OSSGolf/osstempo/pcb/renders/v1.0-top.png

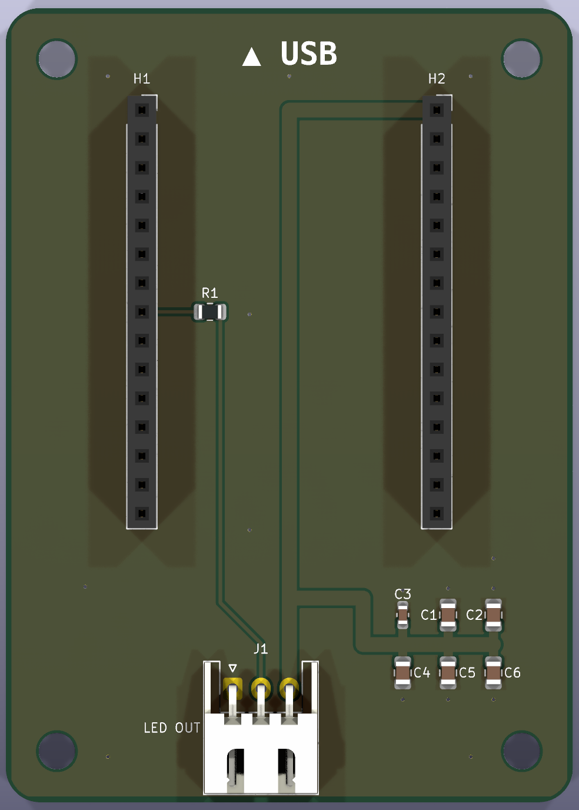
pcb/renders/v1.0-top.png
