OSSGolf/osstempo/pcb/build/jlcpcb_order/osstempo_led_carrier-v1.2-bom.csv

Comment | Designator | Footprint | LCSC Part #
22uF | C1,C2,C3,C4,C5,C6 | C_0805_2012Metric | C45783
470R | R1 | R_0805_2012Metric | C17710
