OSSGolf/osstempo/pcb/routed/osstempo_led_carrier/osstempo_led_carrier.kicad_pcb

## KiCad design pcb/routed/osstempo_led_carrier/osstempo_led_carrier.kicad_pcb (2026-11-03)

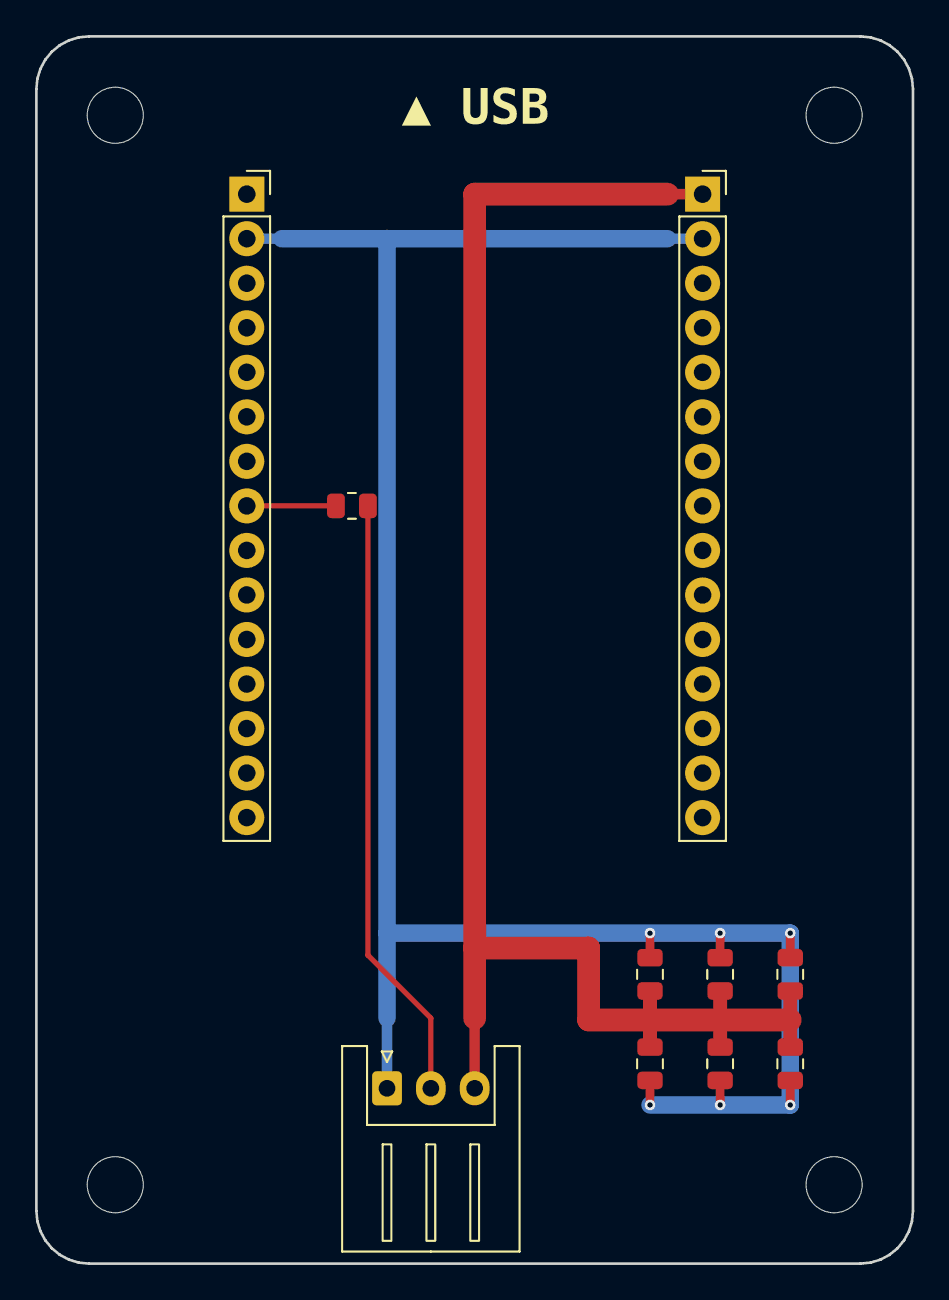
[picture p6: board osstempo_led_carrier.kicad_pcb from above]

Board: 2 copper layers, 50.0 x 70.0 mm, 16 parts (1 on the bottom side), 4 nets.

Parts:
C1, C2, C3, C4, C5, C6: 22uF; C_0805_2012Metric
H1, H2: ESP32_SOCKET; PinSocket_1x15_P2.54mm_Vertical_Pad2.0
J1: LED_OUT; JST_XH_S3B-XH-A_1x03_P2.50mm_Horizontal
MARK1: ▲ USB; Mark_USB_End
MH1, MH2, MH3, MH4: MountingHole_3.2mm
R1: 470R; R_0805_2012Metric
SILK1: arrow / arrow / GND / arrow / D5 / arrow / arrow 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; Silk_Back_v1_2

Connections:
5V: C1.1, C2.1, C3.1, C4.1, C5.1, C6.1, H2.1, J1.3
DIN: J1.2, R1.2
ESP32_IO5: H1.8, R1.1
GND: C1.2, C2.2, C3.2, C4.2, C5.2, C6.2, H1.2, H2.2, J1.1
