OSSGolf/osstempo/tempo_trainer/sync_firmware.ino

/*
 * sync_firmware.ino — ESP-NOW multi-stick sync (FW Phase 2–5, TEMPO_SYNC_PLAN.md).
 * =================================================================================
 * Additive sketch tab. Ephemeral, app-brokered roles held in RAM, default `standalone`
 * at boot (§2.1): WiFi/ESP-NOW is OFF until the app sends becomeLeader/joinSession over
 * BLE, so the lone-stick path pays ZERO coex/RAM cost. A leader broadcasts a SyncBeacon;
 * a follower renders phase-locked off the shared, epoch-anchored clock (§3.4/§4).
 *
 * Compile-verified on both boards; runtime skew/coex is bench-gated (Phase 0 GO required).
 * The shared-grid render integration + core-affinity task are staged (see syncFollowerU()).
 */

#include <WiFi.h>
#include <esp_wifi.h>
#include <esp_now.h>
#include <cstddef>            // offsetof (authTag MAC)
#include <mbedtls/md.h>       // HMAC-SHA256 for the beacon authTag (§4.2.1)
#include "sync_firmware.h"    // SyncRole enum + externs for the state the main tab reads

// ---- Ephemeral role (RAM only; default standalone at every boot). Non-static: matches the
//      extern declarations in sync_firmware.h so the main tab can read them. ----
volatile SyncRole syncRole = ROLE_STANDALONE;
static volatile bool wifiUp = false;            // up on core 0 (becomeLeader/join), down on core 1 (revert)
void syncDoDisband();                            // core-1 disband worker (defined below; called before its def)
void leaderServicePongs();                       // core-1 pong TX (defined below)
static uint8_t  chOp = 6;                       // operating channel handed by the app (§5.1)
static uint8_t  sessionKey[16] = {0};           // per-session key (RAM; authenticates the beacon, §4.2.1)
static uint16_t sessionId = 0;

static uint8_t BROADCAST_ADDR[6] = { 0xFF,0xFF,0xFF,0xFF,0xFF,0xFF };
static uint8_t myMac[6] = {0};                  // this stick's STA MAC (follower identity for identify)

// (SyncBeacon + BEACON_FLAG_DISBAND are declared in sync_firmware.h so the main tab sees them.)

// ---- Leader beacon state ----
static uint32_t beaconSeq = 0;
int64_t         leaderEpochUs = 0;              // shared cycle epoch (leader clock) — extern (header)
static uint32_t lastBeaconMs = 0;
static const uint32_t BEACON_KEEPALIVE_MS = 250;   // 4 Hz (§4.4)
static int64_t  leaderZeroSinceUs = 0;             // when the leader last had 0 followers (self-revert backstop)

// ---- Follower clock-offset estimate (min-filter over the last N samples, §4.3) ----
static const int OFFSET_WINDOW = 16;
static int64_t offsetSamples[OFFSET_WINDOW];
static int     offsetCount = 0, offsetIdx = 0;
static int64_t clockOffsetUs = 0;               // best clock offset (round-trip θ when available)
static int64_t owdUs = 0;                       // one-way delay from the round-trip pong (§4.3)
static bool    haveRtt = false;                 // do we have a round-trip offset yet?
static int64_t lastBeaconRxUs = 0;
static uint32_t followerLastSeq = 0;            // replay guard (monotonic seq, §4.2.1)
static bool    followerEverHeard = false;       // T_JOIN fast-revert if we never heard a beacon
static int64_t followerJoinUs = 0;              // when we became a follower (for the T_JOIN timeout)
static volatile uint32_t lastPingId = 0;        // our outstanding ping's id: 32-bit ⇒ atomic cross-core match (no torn 64-bit read)
static uint32_t pingIdNext = 0;                 // core-1 monotonic ping id, seeded per-follower from the MAC
static uint32_t lastPingMs = 0;

// Follower clock slew (§4.3/§13): ramp small offset corrections across frames, snap on first lock / big
// jump, so a fresh estimate every ~2 s can't hop the comet mid-stroke. Constants are bench-tunable.
static bool    followerOffsetInit = false;
static int64_t appliedOffsetUs = 0;
static const int64_t OFFSET_SLEW_STEP_US = 200;      // max correction per render tick (~250 Hz)
static const int64_t OFFSET_SNAP_US      = 3000;     // beyond this, snap (first lock / leader reboot)

// Deferred actions: SET in the RX callback (core 0), PERFORMED in loop() (core 1, the radio owner).
static volatile bool pendingRevert = false;     // #1: WiFi teardown must NOT run in the RX callback
static volatile bool identifyPending = false;   // #5: identifyBlink() (720ms) must NOT run in the callback
static volatile bool disbandPending = false;    // #4/#6: disband beacon-storm + teardown belong on core 1
static volatile bool statusDirty = false;       // #1: the …0012 BLE notify must NOT run in the RX callback

// Round-trip pong requests handed from the RX callback (core 0) to loop (core 1) so the pong is TXed
// OFF the WiFi RX callback (#2). SPSC ring under a portMUX; leaderTx is stamped at actual send time.
struct PongReq { uint32_t pingId; int64_t followerTx; int64_t leaderRx; };
static const int PONG_Q_CAP = 4;
static PongReq pongQueue[PONG_Q_CAP];
static int pongCount = 0;                        // guarded by pongMux (the spinlock is the barrier), like followerN
static portMUX_TYPE pongMux = portMUX_INITIALIZER_UNLOCKED;

// Follower render state, published via a SEQLOCK: single writer (core-0 RX cb), single reader
// (core-1 loop). Prevents torn reads of the 64-bit clock + the ~24-byte kinematic set (plan §3.5).
// (FollowerPub is declared in sync_firmware.h so the auto-prototypes resolve.)
static volatile uint32_t pubSeq = 0;
static FollowerPub pub = {};
static inline void publishFollower(const FollowerPub &v) {
  uint32_t s = pubSeq; pubSeq = s + 1;                   // odd → writing (explicit store: no volatile-++ warning)
  __sync_synchronize(); pub = v; __sync_synchronize();
  pubSeq = s + 2;                                        // even → published
}
static inline bool readFollower(FollowerPub &out) {
  for (int t = 0; t < 5; t++) {
    uint32_t s0 = pubSeq; __sync_synchronize();
    if (s0 & 1) continue;
    out = pub; __sync_synchronize();
    if (pubSeq == s0) return true;
  }
  return false;
}

// ---- Follower health as the leader tracks it (for the …0012 report), §6/§12 ----
struct FollowerRec { uint8_t mac[6]; int64_t lastHelloUs; bool settled; };
static const int MAX_FOLLOWERS = 4;
static FollowerRec followers[MAX_FOLLOWERS];
static int followerN = 0;
static portMUX_TYPE followersMux = portMUX_INITIALIZER_UNLOCKED;   // #7: core-0 add vs core-1 prune

// =====================================================================================
//  Radio bring-up / tear-down (paid ONLY while a set is active).
// =====================================================================================
static void syncWifiUp() {
  if (wifiUp) return;
  WiFi.mode(WIFI_STA);
  WiFi.disconnect(false, true);
  esp_wifi_set_ps(WIFI_PS_NONE);
  esp_wifi_set_channel(chOp, WIFI_SECOND_CHAN_NONE);
  esp_wifi_get_mac(WIFI_IF_STA, myMac);                 // our identity for addressed identify (§13-ask-2)
  if (esp_now_init() == ESP_OK) {
    esp_now_peer_info_t peer = {};
    memcpy(peer.peer_addr, BROADCAST_ADDR, 6);
    peer.channel = chOp; peer.encrypt = false;
    esp_now_add_peer(&peer);
    wifiUp = true;
  }
}

// Leader → a specific follower: broadcast an addressed identify; only the matching MAC blinks (§13-ask-2).
// Queue this stick's own identify blink for loop() on core 1. Called from the BLE task, which must
// never run the 720 ms blocking blink itself -- it writes leds[] and latches the strip concurrently
// with the renderer.
void syncDeferIdentifySelf() { identifyPending = true; }

void syncIdentifyFollower(const uint8_t mac[6]) {
  if (syncRole != ROLE_LEADER || !wifiUp) return;
  uint8_t pkt[8] = { 'I', 'D', mac[0], mac[1], mac[2], mac[3], mac[4], mac[5] };
  esp_now_send(BROADCAST_ADDR, pkt, sizeof(pkt));
}

static void syncWifiDown() {
  if (!wifiUp) return;
  esp_now_deinit();
  WiFi.mode(WIFI_OFF);
  wifiUp = false;
}

// =====================================================================================
//  Follower: receive + estimate the shared clock.
// =====================================================================================
// Pick the LEAST-delayed sample (§4.3). Each sample = txEspTimer + owd − rx = θ − (delay − owd), which
// DECREASES as queueing delay grows — so the least-delayed packet is the MAXIMUM sample (closest to the
// true offset θ), not the minimum. (Selecting the min would lock onto the most coex-delayed packet.)
static int64_t bestOffsetSample() {
  int64_t m = offsetSamples[0];
  for (int i = 1; i < offsetCount; i++) if (offsetSamples[i] > m) m = offsetSamples[i];
  return m;
}

// Push the …0012 follower-status blob to the app (the set-health channel, §12).
void notifyFollowerStatus() {
  if (!chFollowerStat) return;
  uint8_t buf[1 + MAX_FOLLOWERS * 7];
  int n = syncFollowerStatus(buf, sizeof(buf));
  chFollowerStat->setValue(buf, n);
  chFollowerStat->notify();
}

// Leader-side: track a follower by its source MAC (any packet on our session is a "hello", §6).
static void leaderTrackFollower(const uint8_t *mac, bool settled) {
  bool added = false;
  int64_t now = esp_timer_get_time();
  portENTER_CRITICAL(&followersMux);                      // #7: guard the shared table vs the core-1 prune
  int i;
  for (i = 0; i < followerN; i++) {
    if (memcmp(followers[i].mac, mac, 6) == 0) { followers[i].lastHelloUs = now; followers[i].settled = settled; break; }
  }
  if (i == followerN && followerN < MAX_FOLLOWERS) {
    memcpy(followers[followerN].mac, mac, 6);
    followers[followerN].lastHelloUs = now;
    followers[followerN].settled = settled;
    followerN++; added = true;
  }
  portEXIT_CRITICAL(&followersMux);
  if (added) statusDirty = true;                           // #1: defer the BLE notify to loop (core 1), not this RX callback
}

// HMAC-SHA256 over the beacon (all bytes before authTag), keyed by the per-session key, truncated to
// 8 bytes — spoof/replay rejection (§4.2.1). ESP32 mbedtls uses the hardware SHA accelerator.
static void computeAuthTag(const SyncBeacon &b, uint8_t out[8]) {
  uint8_t full[32] = {0};
  const mbedtls_md_info_t *info = mbedtls_md_info_from_type(MBEDTLS_MD_SHA256);
  if (info && mbedtls_md_hmac(info, sessionKey, 16, (const uint8_t *)&b,
                              offsetof(SyncBeacon, authTag), full) == 0) {
    memcpy(out, full, 8);
  } else {
    memset(out, 0, 8);
  }
}

// Single recv callback for both roles: a leader hears follower hellos; a follower hears beacons.
static void onSyncRecv(const esp_now_recv_info_t *info, const uint8_t *data, int len) {
  if (len < 3) return;
  if (syncRole == ROLE_LEADER) {
    if (data[0] == 'H' && data[1] == 'L') { leaderTrackFollower(info->src_addr, data[2] != 0); return; }
    if (data[0] == 'P' && data[1] == 'G' && len >= 14) {          // round-trip OWD ping → ENQUEUE a pong (#2)
      int64_t leaderRx = esp_timer_get_time();                    // stamp T2 in-callback; T3 stamped at TX time
      PongReq req; memcpy(&req.pingId, data + 2, 4); memcpy(&req.followerTx, data + 6, 8); req.leaderRx = leaderRx;
      portENTER_CRITICAL(&pongMux);
      if (pongCount < PONG_Q_CAP) pongQueue[pongCount++] = req;   // drop on overflow: the follower re-pings in ~2 s
      portEXIT_CRITICAL(&pongMux);
    }
    return;
  }
  // Round-trip OWD pong: NTP four-timestamp offset θ + one-way delay δ/2 (§4.3). Match on the 32-bit
  // pingId (atomic, #9) and take T1 from the echoed followerTx — no torn 64-bit read of our own state.
  if (syncRole == ROLE_FOLLOWER && len >= 30 && data[0] == 'P' && data[1] == 'O') {
    uint32_t pingId; int64_t followerTx, leaderRx, leaderTx, followerRx = esp_timer_get_time();
    memcpy(&pingId, data + 2, 4);
    memcpy(&followerTx, data + 6, 8);
    memcpy(&leaderRx, data + 14, 8);
    memcpy(&leaderTx, data + 22, 8);
    if (pingId == lastPingId) {
      clockOffsetUs = ((leaderRx - followerTx) + (leaderTx - followerRx)) / 2;   // offset θ (bias-cancelled)
      owdUs         = ((followerRx - followerTx) - (leaderTx - leaderRx)) / 2;   // one-way delay
      haveRtt = true;
    }
    return;
  }
  // Addressed identify: blink only if the target MAC is ours — DEFERRED to loop (720 ms blocking). #5.
  if (syncRole == ROLE_FOLLOWER && len >= 8 && data[0] == 'I' && data[1] == 'D') {
    if (memcmp(data + 2, myMac, 6) == 0) identifyPending = true;
    return;
  }
  if (syncRole != ROLE_FOLLOWER || len < (int)sizeof(SyncBeacon)) return;
  SyncBeacon b; memcpy(&b, data, sizeof(b));
  if (b.magic[0] != 'O' || b.magic[1] != 'T' || b.sessionId != sessionId) return;
  uint8_t tag[8]; computeAuthTag(b, tag);                 // spoof/replay: drop any beacon whose MAC fails (§4.2.1)
  if (memcmp(tag, b.authTag, 8) != 0) return;
  if (b.seq && b.seq < followerLastSeq && (followerLastSeq - b.seq) < 256) return;   // #4: small replay window
  // #5: a large backward seq jump = the leader REBOOTED (its esp_timer restarted near 0). Drop every stale
  // clock estimate and re-lock from scratch, else we'd render off the old leader's uptime for ~2 s.
  if (b.seq < followerLastSeq && (followerLastSeq - b.seq) >= 256) {
    haveRtt = false; owdUs = 0; offsetCount = 0; offsetIdx = 0; followerOffsetInit = false;
  }
  followerLastSeq = b.seq;
  if (b.flags & BEACON_FLAG_DISBAND) { pendingRevert = true; return; }   // #1: DEFER teardown out of the callback

  int64_t rx = esp_timer_get_time();
  offsetSamples[offsetIdx] = b.txEspTimer + owdUs - rx;   // sample = tx + OWD − rx (§4.3)
  offsetIdx = (offsetIdx + 1) % OFFSET_WINDOW;
  if (offsetCount < OFFSET_WINDOW) offsetCount++;

  FollowerPub v;                                          // #6: publish the whole delta atomically (seqlock)
  v.epochUs    = b.epochEspTimer;
  v.offsetUs   = haveRtt ? clockOffsetUs : bestOffsetSample();   // #3: round-trip wins; least-delayed sample is the fallback
  v.params     = b.active;
  v.control    = b.control;
  v.mode       = b.mode;                                  // #2: adopt the leader's mode/getReady/hold/rest
  v.getReadyMs = b.getReadyMs; v.holdMs = b.holdMs; v.restMs = b.restMs;
  v.brightness = b.brightness; v.railsLit = b.railsLit;
  publishFollower(v);
  lastBeaconRxUs = rx;
  followerEverHeard = true;
}

// Follower: send a ~1 Hz hello so the leader can count/health-track it. Called from loop().
static uint32_t lastHelloMs = 0;
void followerHelloTick() {
  if (syncRole != ROLE_FOLLOWER || !wifiUp) return;
  uint32_t nowMs = millis();
  if (nowMs - lastHelloMs < 1000) return;
  lastHelloMs = nowMs;
  uint8_t settled = (offsetCount >= OFFSET_WINDOW) ? 1 : 0;   // clock-locked once the min-filter fills (§13-ask-5)
  uint8_t hello[3] = { 'H', 'L', settled };
  esp_now_send(BROADCAST_ADDR, hello, sizeof(hello));
}

// Follower: ~0.5 Hz round-trip ping so the leader can echo timestamps for OWD calibration (§4.3).
void followerPingTick() {
  if (syncRole != ROLE_FOLLOWER || !wifiUp) return;
  uint32_t nowMs = millis();
  if (nowMs - lastPingMs < 2000) return;
  lastPingMs = nowMs;
  int64_t followerTx = esp_timer_get_time();
  uint32_t pid = ++pingIdNext;               // 32-bit id the pong echoes back — atomic cross-core match (#9)
  lastPingId = pid;
  uint8_t pkt[14] = { 'P', 'G' };
  memcpy(pkt + 2, &pid, 4);
  memcpy(pkt + 6, &followerTx, 8);
  esp_now_send(BROADCAST_ADDR, pkt, sizeof(pkt));
}

// Leader: TX any queued round-trip pongs from loop (core 1), stamping T3 (leaderTx) at actual send time
// so the four-timestamp offset stays correct despite the off-callback deferral (#2). Called each loop.
void leaderServicePongs() {
  if (syncRole != ROLE_LEADER || !wifiUp) return;
  for (;;) {
    PongReq req; bool have = false;
    portENTER_CRITICAL(&pongMux);
    if (pongCount > 0) { req = pongQueue[0]; for (int i = 1; i < pongCount; i++) pongQueue[i - 1] = pongQueue[i]; pongCount--; have = true; }
    portEXIT_CRITICAL(&pongMux);
    if (!have) break;
    int64_t leaderTx = esp_timer_get_time();
    uint8_t pong[30] = { 'P', 'O' };
    memcpy(pong + 2,  &req.pingId, 4);
    memcpy(pong + 6,  &req.followerTx, 8);
    memcpy(pong + 14, &req.leaderRx, 8);
    memcpy(pong + 22, &leaderTx, 8);
    esp_now_send(BROADCAST_ADDR, pong, sizeof(pong));
  }
}

// §7 follower ingestion: cosmetic (brightness/rails/aim2) applies IMMEDIATELY; kinematic (mode,
// get-ready/hold/rest, and the Profile timeline) merges only at a cycle boundary (u wrap) so a
// mid-cycle change can't jump the comet's phase. Reads the seqlock snapshot; runs on core 1.
static float followerLastU = 1e9f;
static bool  followerKinInit = false;
static void applyFollowerParamsFrom(const FollowerPub &fp, float u) {
  if (brightness != fp.brightness) { brightness = fp.brightness; FastLED.setBrightness(brightness); }
  railsLit = fp.railsLit;
  if (!followerKinInit || u < followerLastU) {                 // first synced frame, or a cycle wrap
    mode = fp.mode; getReadyMs = fp.getReadyMs; holdMs = fp.holdMs; restMs = fp.restMs;
    profiles[mode] = fp.params;                                // whole timeline (kinematic + aim2) at boundary
    followerKinInit = true;
  } else {
    profiles[mode].aim2Enabled = fp.params.aim2Enabled;        // aim2 position/enable are cosmetic → immediate
    profiles[mode].aim2Led     = fp.params.aim2Led;
  }
  followerLastU = u;
}

// Perform actions deferred out of the RX callback, on core 1 (the radio owner). #1/#5.
void syncDrainDeferred() {
  leaderServicePongs();                                       // #2: TX queued round-trip pongs off the RX callback
  if (statusDirty)     { statusDirty = false;     notifyFollowerStatus(); }   // #1: deferred …0012 BLE notify
  if (disbandPending)  { disbandPending = false;  syncDoDisband(); }          // #4/#6: deferred disband storm + teardown
  if (pendingRevert)   { pendingRevert = false;   syncRevertToStandalone(); }
  // Clear BEFORE the blink. Clearing after would swallow every request arriving during the 720 ms
  // blink — tap identify twice and the second tap vanishes. Clearing first narrows the drop window
  // to the few instructions between the test and the clear, and a request landing there simply
  // re-arms the flag and is serviced on the next drain.
  if (identifyPending) { identifyPending = false; identifyBlink(); }
}

// One follower render tick: send hello/ping, snapshot the shared state (seqlock), render off the
// shared clock. Called from loop() (core 1). Stateless renderer ⇒ agree on u ⇒ identical frame (§3.4).
static float followerLastFrameU = -1.0f;                      // frame-skip: last quantized u rendered (-2 = blanked)

// Force the follower render path to repaint on its next tick. The main tab's invalidateFrameSkip()
// calls this alongside its own sentinel, so neither tab reaches into the other's private state.
void syncInvalidateFollowerFrameSkip() { followerLastFrameU = -1.0f; }
void followerRenderStep() {
  followerHelloTick();
  followerPingTick();
  FollowerPub fp;
  if (!readFollower(fp)) return;                               // torn read this tick — retry next
  // #8: slew toward the latest offset estimate; snap on first lock / big jump so it can't hop mid-stroke.
  int64_t target = fp.offsetUs;
  if (!followerOffsetInit) { appliedOffsetUs = target; followerOffsetInit = true; }
  else {
    int64_t d = target - appliedOffsetUs;
    if (d > OFFSET_SNAP_US || d < -OFFSET_SNAP_US) appliedOffsetUs = target;   // large discontinuity → snap
    else if (d >  OFFSET_SLEW_STEP_US) appliedOffsetUs += OFFSET_SLEW_STEP_US; // small correction → ramp
    else if (d < -OFFSET_SLEW_STEP_US) appliedOffsetUs -= OFFSET_SLEW_STEP_US;
    else appliedOffsetUs = target;
  }
  int64_t sharedNow = esp_timer_get_time() + appliedOffsetUs;
  float u = (sharedNow < fp.epochUs) ? 0.0f : (sharedNow - fp.epochUs) / 1000.0f;
  applyFollowerParamsFrom(fp, u);
  if (fp.control == 1 || fp.control == 2) {
    if (u < cycleDuration(profiles[mode])) {
      float qu = gridQuantize(u);                             // shared frame grid (§3.4); skip duplicate frames
      if (qu != followerLastFrameU) { followerLastFrameU = qu; renderFrameAt(qu); }
    } else if (followerLastFrameU != -2.0f) { followerLastFrameU = -2.0f; clearLeds(); showFrame(); }   // rest/idle gap
  } else {
    followerLastFrameU = -1.0f;
    fadeToBlackBy(leds, NUM_LEDS, 40);
    leds[(int)roundf(CENTER)] = CRGB(0, 40, 0);
    showFrame();
  }
}

// =====================================================================================
//  Leader: broadcast the beacon on the shared grid.
// =====================================================================================
static void fillBeacon(SyncBeacon &b, uint8_t flags) {
  memset(&b, 0, sizeof(b));                              // zero Profile padding → deterministic HMAC (#12)
  b.magic[0] = 'O'; b.magic[1] = 'T'; b.version = 1;
  b.sessionId = sessionId; b.flags = flags;
  b.seq = ++beaconSeq;
  b.txEspTimer = esp_timer_get_time();
  b.control = control;
  b.epochEspTimer = leaderEpochUs;
  b.active = profiles[mode];
  b.mode = mode; b.getReadyMs = getReadyMs; b.holdMs = holdMs; b.restMs = restMs;   // KINEMATIC globals (§7)
  b.brightness = brightness; b.railsLit = railsLit;      // cosmetic globals (§7)
  computeAuthTag(b, b.authTag);                          // keyed MAC over all preceding bytes (§4.2.1)
}

static volatile bool leaderEventPending = false;         // #9: control/param/boundary change → burst now
void leaderMarkEvent() { leaderEventPending = true; }     // set from any context; sent from loop (core 1)

void leaderBeaconTick() {
  if (syncRole != ROLE_LEADER || !wifiUp) return;
  uint32_t nowMs = millis();
  bool event = leaderEventPending;
  if (event) leaderEventPending = false;
  if (!event && nowMs - lastBeaconMs < BEACON_KEEPALIVE_MS) return;   // else keepalive throttle
  lastBeaconMs = nowMs;
  int repeats = event ? 4 : 1;                            // event beacons repeated 4× over a few hundred µs (§4.4)
  for (int i = 0; i < repeats; i++) {
    SyncBeacon b; fillBeacon(b, 0);                       // fresh seq/tx each repeat (feeds the offset filter)
    esp_now_send(BROADCAST_ADDR, (const uint8_t *)&b, sizeof(b));
    if (i + 1 < repeats) delayMicroseconds(800);
  }
}

// =====================================================================================
//  App-brokered lifecycle — called by the …0013 BLE session-command handler.
// =====================================================================================
void syncBecomeLeader(uint16_t sid, const uint8_t key[16], uint8_t channel) {
  // #7: re-sending becomeLeader to a live leader is a no-op (plan §6/§22) — must not reset the shared
  // epoch or wipe the follower table, which would desync the set and trip the zero-follower backstop.
  if (syncRole == ROLE_LEADER && wifiUp) return;
  sessionId = sid; memcpy(sessionKey, key, 16); chOp = channel;
  syncRole = ROLE_LEADER;
  leaderEpochUs = esp_timer_get_time();
  followerN = 0;
  leaderZeroSinceUs = esp_timer_get_time();             // start the zero-follower backstop clock (§13-ask-6)
  syncWifiUp();
  esp_now_register_recv_cb(onSyncRecv);                 // also hears follower hellos (count/health)
}

void syncJoinSession(uint16_t sid, const uint8_t key[16], uint8_t channel) {
  sessionId = sid; memcpy(sessionKey, key, 16); chOp = channel;
  syncRole = ROLE_FOLLOWER;
  // Go BLE-quiet HERE rather than relying on ServerCB::onDisconnect seeing the new role. Session
  // formation is deferred to core 1, so the app's disconnect (sent straight after the …0013 write)
  // can arrive BEFORE this runs — and onDisconnect would then re-advertise a stick that is about to
  // become a follower, leaving it discoverable and burning coex airtime for the life of the set.
  // syncRevertToStandalone() re-advertises on the way out (§2.1).
  BLEDevice::stopAdvertising();
  offsetCount = 0; offsetIdx = 0; clockOffsetUs = 0; owdUs = 0; haveRtt = false;
  followerOffsetInit = false; syncInvalidateFollowerFrameSkip();   // #8: re-lock the slewed clock from scratch
  followerLastSeq = 0;                                  // #4: don't carry a prior session's seq (reboot/rejoin)
  followerEverHeard = false; followerJoinUs = esp_timer_get_time();
  followerKinInit = false; followerLastU = 1e9f;        // re-merge kinematic params on the first synced frame
  lastBeaconRxUs = esp_timer_get_time();
  syncWifiUp();                                         // fills myMac; seed a per-follower ping-id base so two
  pingIdNext = ((uint32_t)myMac[2] << 24) | ((uint32_t)myMac[3] << 16)   // followers can't collide on the id
             | ((uint32_t)myMac[4] << 8)  |  (uint32_t)myMac[5];
  esp_now_register_recv_cb(onSyncRecv);
  // BLE is dropped by the app side after this write; the stick now renders off the beacon.
}

// Called from the BLE session-command handler (core 0) — DEFER the beacon-storm + radio teardown to
// loop (core 1) so esp_now_deinit() never races the WiFi RX callback and never blocks the BLE task (#4/#6).
void syncDisband() { disbandPending = true; }

// Performed on core 1 via syncDrainDeferred: broadcast repeated DISBAND, then revert.
void syncDoDisband() {
  if (syncRole == ROLE_LEADER && wifiUp) {
    for (int i = 0; i < 5; i++) {                         // repeated DISBAND (§4.4/§6)
      SyncBeacon b; fillBeacon(b, BEACON_FLAG_DISBAND);
      esp_now_send(BROADCAST_ADDR, (const uint8_t *)&b, sizeof(b));
      delay(30);
    }
  }
  syncRevertToStandalone();
}

void syncRevertToStandalone() {
  bool wasFollower = (syncRole == ROLE_FOLLOWER);
  syncWifiDown();
  syncRole = ROLE_STANDALONE;
  portENTER_CRITICAL(&followersMux); followerN = 0; portEXIT_CRITICAL(&followersMux);   // #7
  if (wasFollower) {                                    // a follower's RAM params were the LEADER's — restore ours
    // Orientation is DEVICE-LOCAL: a sync session never owns it, so it must survive this restore.
    // loadParams() would reload `flipped` from NVS, which can predate a toggle whose commit had not
    // yet reached a safe save point -- silently rotating the strip on revert. (Narrow residual race:
    // the T_JOIN fast revert can fire while an app is still connected, so a flip write landing on
    // core 0 during these blocking NVS reads would be overwritten. Unreachable in practice, since a
    // follower is BLE-quiet, and self-corrects on the next write.)
    const uint8_t keepFlip = flipped;
    loadParams();                                       // (matters cross-build: a dig2go follower of a generic
    flipped = keepFlip;
    FastLED.setBrightness(brightness);                  //  leader must return to ITS own saved config on disband)
    followerKinInit = false;
    BLEDevice::startAdvertising();                       // was BLE-quiet while synced (§2.1) → advertise so it's re-addable
  }
}

// Two-threshold never-stuck revert (§6/§8): a follower that loses beacons past T_ORPHAN
// reverts to standalone (re-enables BLE). Called from loop().
static const int64_t T_ORPHAN_US = 20 * 1000000LL;       // a few s beyond DEGRADE_S (bench-tuned)
static const int64_t T_HELLO_US   = 20 * 1000000LL;      // ≥ T_ORPHAN so leader teardown ≥ follower revert (§6)
static const int64_t T_JOIN_BACKSTOP_US = 8 * 1000000LL; // leader-with-zero-followers self-revert (§13-ask-6)
static const int64_t T_JOIN_US    = 4 * 1000000LL;       // #8: never-heard-a-beacon fast revert (§6/§8)
void syncServiceTimeouts() {
  int64_t now = esp_timer_get_time();
  if (syncRole == ROLE_FOLLOWER) {
    // #8: never synced (app crashed between joinSession and becomeLeader) → fast revert, don't sit dark 20 s.
    if (!followerEverHeard && now - followerJoinUs > T_JOIN_US) { syncRevertToStandalone(); return; }
    if (now - lastBeaconRxUs > T_ORPHAN_US) { syncRevertToStandalone(); return; }   // was-synced → full coast
    return;
  }
  if (syncRole == ROLE_LEADER) {
    // Prune followers whose hello timed out (they orphaned) and re-report the count (§6/§12).
    int before = followerN;
    portENTER_CRITICAL(&followersMux);                    // #7: guard vs the core-0 add
    for (int i = 0; i < followerN; ) {
      if (now - followers[i].lastHelloUs > T_HELLO_US) {
        for (int j = i; j < followerN - 1; j++) followers[j] = followers[j + 1];
        followerN--;
      } else i++;
    }
    int after = followerN;
    portEXIT_CRITICAL(&followersMux);
    if (after != before) notifyFollowerStatus();          // BLE notify OUTSIDE the critical section
    // Zero-follower backstop: a leader that never gets (or loses all) followers reverts to standalone
    // so the app crashing mid-add can't strand a WiFi-up zombie leader (§13-ask-6 / plan §5.3-5).
    if (followerN > 0) leaderZeroSinceUs = 0;
    else {
      if (leaderZeroSinceUs == 0) leaderZeroSinceUs = now;
      else if (now - leaderZeroSinceUs > T_JOIN_BACKSTOP_US) syncRevertToStandalone();
    }
  }
}

// Serialize the …0012 follower-status blob: [count][ (handle:6 mac)(flags:1) ]* (§12).
// Snapshots the table under the lock (#7) — memcpy only, no BLE inside the critical section.
int syncFollowerStatus(uint8_t *out, int cap) {
  if (cap < 1) return 0;
  int64_t now = esp_timer_get_time();
  int n = 0;
  portENTER_CRITICAL(&followersMux);
  out[n++] = (uint8_t)followerN;
  for (int i = 0; i < followerN && n + 7 <= cap; i++) {
    memcpy(out + n, followers[i].mac, 6); n += 6;
    int64_t age = now - followers[i].lastHelloUs;
    uint8_t flags = 0;
    if (age > 15 * 1000000LL) flags |= 0x01;             // re-linking (stale age, §13-ask-1)
    if (followers[i].settled)  flags |= 0x02;            // clock locked (§13-ask-5)
    out[n++] = flags;
  }
  portEXIT_CRITICAL(&followersMux);
  return n;
}
