OSSGolf/osstempo/(commit log)

2026-07-06 Initialize OSSTempo firmware, web client, and build docs
    First public commit under OSSGolf. Board-selectable Arduino/FastLED ESP32 firmware (generic DIY ESP32 or QuinLED-Dig2go), a Web Bluetooth control page, and build documentation for both hardware paths. The native iOS controller lives in the separate osstempo-ios repo.
    Claude-Session: https://claude.ai/code/session_015aSJWqpsAebJ6JwuD9CSwu
2026-07-13 Add ESP-NOW multi-stick sync design (TEMPO_SYNC_PLAN.md)
    Decision-complete LLD for synchronizing two+ tempo-trainer sticks over
    ESP-NOW so their comet animations are visually locked (< 3 ms skew) —
    "smart alignment sticks." Passed L9 design review and an independent
    adversarial red-team (v5.1).
    Core decisions: analytic stateless renderer on a shared epoch-anchored
    frame grid (show()/quantization common-mode, zero skew); core-1 render /
    core-0 radios execution model with NVS gated to the dark window; per-cycle
    epoch with cycle-boundary kinematic swaps (cosmetic applies live); keyed-MAC
    beacon auth; spike-first phasing so the BLE+ESP-NOW coexistence go/no-go
    costs nothing and never regresse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
2026-07-13 Sync plan v6.2: fluid, app-brokered, ephemeral roles
    Refines the ESP-NOW sync design so any stick can be leader/follower/
    standalone at any time on any phone, with role as ephemeral RAM state
    (default standalone at boot, never persisted) — one firmware image, no
    permanent pairing, seamless in the existing app. The phone brokers
    becomeLeader/joinSession/disband over BLE; a follower auto-reverts on
    authenticated DISBAND / two-threshold timeout / reboot.
    Passed a fresh L9 design review (v6.1, after fixing a circular WiFi-up
    trigger that would have deadlocked set formation) and an independent
    adversarial red-team (v6.2, unconditional — after fixing join-success
    detection, LESC/JustWorks hon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
2026-07-14 Add multi-stick ESP-NOW sync firmware (compile-verified; runtime bench-gated)
    Analytic stateless renderer on a shared epoch-anchored frame grid + the full
    ESP-NOW leader/follower protocol, per TEMPO_SYNC_PLAN.md v6.2.
    Renderer (tempo_trainer.ino):
    - positionAt(u,p) pure/stateless, both modes, golden-parity-verified in
    firmware_tests/golden_kinematics.c; renderFrameAt(u) with segment-identity
    direction and an analytic trail (no IIR, no static state).
    - Non-blocking loop replaces the blocking stroke loops; NVS gated to idle;
    shared frame grid via gridQuantize(u).
    Sync (sync_firmware.ino/.h):
    - Ephemeral roles (standalone default; WiFi off until a set forms).
    - SyncBeacon + WiFi/ESP-NOW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
    [phase0_coex.ino, sync_firmware.h, sync_firmware.ino, tempo_trainer.ino]
2026-07-14 Add round-trip OWD clock calibration (NTP four-timestamp)
    Follower sends a ~0.5 Hz timestamped ping; leader echoes its rx/tx timestamps;
    follower computes the clock offset via the NTP four-timestamp formula, removing
    the one-way-delay bias in the beacon min-filter estimate (plan §4.3). Completes
    the "min-filter + round-trip clock offset" firmware item.
    Both builds compile clean (--warnings all, zero project warnings). Accuracy is
    bench-verified (needs measured link timing).
    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
2026-07-14 Fix 11 correctness bugs from the review pass (compile-verified)
    Adversarial review of the never-run sync firmware found real bugs:
    - #1 esp_now_deinit()/WiFi-off from INSIDE the ESP-NOW RX callback (crash/deadlock
    on the first disband) -> deferred to loop() via a volatile flag; same for the
    720ms identifyBlink() (#5).
    - #2 beacon omitted mode/getReadyMs/holdMs/restMs -> a follower rendered a different
    stroke entirely; added them, adopted at the cycle boundary.
    - #3 the 4 Hz beacon min-filter clobbered the round-trip OWD offset every 250ms ->
    keep a separate owd/haveRtt (round-trip wins, min-filter fallback) + the +OWD term.
    - #4 replay guard rejected a rebooted/rejoined leader (seq r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
    [sync_firmware.h, sync_firmware.ino, tempo_trainer.ino]
2026-07-15 Cross-build sync (dig2go <-> generic ESP32): L9 PASS + follower re-add fix
    Verify and harden sync so a dig2go and a generic ESP32 form a set (either as
    leader/follower) at firmware + iOS levels. Analysis in CROSS_BUILD_SYNC.md; L9
    review PASS -- the board delta is only LED_PIN/LED_POWER in setup(); the wire
    format, clock, renderer and role machine are board-independent, so both builds
    emit byte-identical beacons and identical frames for a given shared u.
    - ServerCB::onDisconnect re-advertises UNLESS a synced follower (BLE-quiet per
    §2.1); syncRevertToStandalone re-advertises on follower revert. Fixes: a
    reverted follower was left undiscoverable and could not be re-added without a
    reb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
    [sync_firmware.h, sync_firmware.ino, tempo_trainer.ino, tempo_trainer_dig2go.ino, tempo_trainer_diy.ino]
2026-07-15 Sync L9 pass — firmware correctness, clock, and stop/start fixes
    Verified via a 6-agent adversarial review; both boards compile clean
    (--warnings all, 63%/19%) and golden-kinematics parity is 0 failures.
    Renderer / params (tempo_trainer):
    - Leader boundary-snapshots kinematic params (§7: pendingKin + pendingMerge
    under portMUX). It was rendering profiles[mode] LIVE every frame, so the
    leader desynced from its followers (which apply kinematics at the boundary)
    on any mid-cycle edit, and standalone teleported the comet.
    - Restore the get-ready countdown pulses analytically in renderFrameAt.
    - GATT characteristics report the CLAMPED written value (read-back consistency).
    - Skip FastLE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
    [sync_firmware.ino, tempo_trainer.ino]
2026-07-15 Remove the retired blocking-render block (dead since the analytic renderer)
    The stateless analytic renderer superseded the blocking stroke drivers; excise the
    now-unreachable code (kept as its own commit per the dead-code-first rule):
    - addComet / drawComet / drawCometRefs / countdownPulses / sweep / sweepDrop /
    holdAt / runStroke / runStrokeFull / runActiveStroke
    - the now-unused EaseFn typedef and the aim2Now global
    showMarkers/showRefs stay (still used by the preview branch). Net -165 lines;
    both boards compile clean.
    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
2026-09-13 Add a 180 flip: mirror the strip end-for-end at the output boundary
    A user can now run the stick from either direction. The renderer already composed
    every frame as a pure function of cycle time, so orientation is purely an output
    property: the frame is built in logical index space and showFrame() mirrors it
    i -> NUM_LEDS-1-i on the way to the strip. Reflection about (NUM_LEDS-1)/2 is
    reflection about CENTER, so the whole picture -- comet head and tail, ball, amber,
    both red extents, purple aim dot, get-ready pulse, idle dot -- mirrors together.
    Nothing in the stroke math changes, so the golden-parity kinematics and the iOS
    port stay untouched.
    Two frame buffers rather than reversing leds[]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
    [sync_firmware.h, sync_firmware.ino, tempo_trainer.ino]
2026-09-13 Add the reverse-direction control to the web page, and document the flip
    The page draws its own picture of the strip, so it mirrors independently of the
    firmware and hits the same trap the app did: ledX and xToLed are a hand-rolled
    inverse pair and the canvas reach-drag reads a pointer position back through
    xToLed, so mirroring only the forward mapping would send every drag on a reversed
    strip to the mirror index and collapse reach to its minimum on first movement.
    Both are mirrored together, and web/check_flip_mapping.js extracts those exact
    source lines from the page and proves they stay exact inverses in both orientations.
    Also fixes the UUID helper, which interpolated a single hex digit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
    [tempo_trainer.ino]
2026-09-13 Fix the firmware defects the post-implementation review found
    The blocker was self-inflicted. My session-command flush put Preferences access on
    the Bluetooth core for the first time in this sketch. Preferences is a stateful
    object whose begin() returns false when it is already open, and no call site checks
    it - so a flush racing the render core's debounced save would close the handle
    mid-save and silently drop whatever that core was writing, both profile blobs
    included. Session formation now defers to the render core like disband and identify
    already do, which keeps all flash access on one core, keeps the flush strictly
    before the role change, and lets it gate on the old role so an already-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
    [sync_firmware.ino, tempo_trainer.ino]
2026-09-13 Fix two regressions the deferral introduced, and close the guard's last gap
    Deferring session formation to the render core moved the role change up to 100 ms
    later than the Bluetooth write that triggers it, which broke two things that had
    been relying on it happening inside the callback.
    - A follower stays quiet on Bluetooth only because the disconnect handler reads
    the new role; nothing ever calls stopAdvertising. With the role change deferred,
    the app's disconnect now arrives first, so the handler re-advertised a stick that
    was about to become a follower and left it discoverable for the life of the set.
    Joining now goes quiet explicitly, so the invariant no longer depend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
    [sync_firmware.h, sync_firmware.ino, tempo_trainer.ino]
2026-11-01 Add the ESP32 carrier PCB: v1.2 source, release, order files and renders
    pcb/ is the board that replaces the two-breadboard build: the 30-pin ESP32 drops
    into two 15-way sockets, JLCPCB places the 470 R and six 22 uF caps, and the three
    connectors are hand-soldered. It is authored as a kicad-agent-toolkit manifest
    (the toolkit itself is a private dependency and is not vendored) and built only
    through pcb/build.sh, which validates twice, reseeds pcb/routed/, writes the
    JLCPCB order set and stops the Podman VM on exit.
    v1.2 is built for hand soldering, because v1.0 was not: with a solid ground plane
    on the back and a pour on the front, no socket pad would heat enough to wet at
    350-420 C until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
    [osstempo_led_carrier-v1.0-bom.csv, osstempo_led_carrier-v1.1-bom.csv, osstempo_led_carrier-v1.2-bom.csv, osstempo_led_carrier.kicad_pcb, osstempo_led_carrier.kicad_sch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]
2026-11-01 Link the carrier PCB and its renders from the project README
    Claude-Session: https://claude.ai/code/session_019VzsJweYDrFrMB9R6twRhe
2026-11-03 Build the board on the osstempo-patches-v2 toolkit branch
    The toolkit branch is now upstream main (2026-11-01) plus our patches: zone fill
    with autoroute off, board.artwork, mounting_hole.hide_reference,
    pcb_no_reference_label, zone pad_connection, and the tht_hand_solder_heat check.
    The corner_radius patch is retired for upstream's corner_radius_mm.
    Upstream's schema moved and the board source follows it:
    - design_considerations block plus a decisions file beside the manifest
    - outline.corner_radius -> corner_radius_mm
    - rule-pack passive checks name a part kind instead of a symbol
    - both passives carry sourced nominal facts and ratings bound to a retained,
    hash-bound datasheet under pcb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
    [osstempo_led_carrier.kicad_pcb]
